AgentD/COMPUTRON-3000/(list of files, drawings)

Other design files:
himem.pcb
main.pcb
power.pcb
romprog/romprog.pcb
uart.pcb
