AgentD/COMPUTRON-3000/(commit log)

2012-10-09 Added footprint and values to power supply
    Also removed unused I/O and address bus and added status LED and changed
    bridge to discrete diodes
    [power.sch]
2012-10-09 Added title blocks
    [cpu.sch, memory.sch, power.sch, rom_cartridge.sch]
2012-10-11 Replaced 74 573 with 574
    - Should work as well, as the data is already on the bus when the CPU
    issues an IORQ/MREQ and RD/WR strobe
    - I have a lot of those
    [cpu.sch, memory.sch]
2012-10-13 Added custom 40 pin DIN 41612 connector symbol
    [cpu.sch, memory.sch, power.sch]
2012-11-13 Turned individual boards into single main board + some overhauls
    - power supply, CPU, address decoder, memory and interrupt decoder
    on single board
    - very simple DIN41617 plain I/O bus
    - more soffisticated address decoder with shared RAM and 1kB boot
    ROM instead of shared ROM
    - no more DMA
    [cpu.sch, main.sch, memory.sch, power.sch, rom_cartridge.sch]
2012-11-17 ERMAHGERD ERSERMBLER!
    Finally sat down to write that pice of cruft. A simple stub of a
    retargetable assembler with label handling and what not.
    Currently has an Intel 8080 backend.
    I need some sleep now...
2012-11-17 Added defines to assembler and fixed syntax of the [ORG] directive
2013-01-19 Some cleaning in the assembler code
    - Made as many helper functions as possible into gerneric
    - Symbols are linked lists
    - Removed binaries
2013-01-27 Finally an update after a long break
    - Removed gschem schematics and symbols
    - Added original design documents
    - Added PCB layouts
    - Updated README
    [cpu.pcb, main.sch, mem.pcb]
2013-02-04 Moved several connections from the top to the bottom side
    [cpu.pcb]
2013-02-04 Moved power source of the bus and to seperate connectors
    [cpu.pcb, mem.pcb]
2013-02-05 Adjusted sizes of the the memory and cpu pcb to 100mm Height (Eurocard)
    [cpu.pcb, mem.pcb]
2013-02-05 Minor simplifications in the memory board pcb
    [mem.pcb]
2013-02-10 Added decoupling caps and ROM compatibillity to memory board
    - Simplified top layer connections
    - Added decoupling capacitors
    - Connected unused ROM address lines to VCC
    -> Simplified layout
    -> Compatibillity for a wide range of both EEPROMs and EPROMs
    [mem.pcb]
2013-02-10 Connected CPU clock with backplane bus
    [cpu.pcb, mem.pcb]
2013-02-10 Added script to generate gerber files
2013-02-17 Removed unsolderable connections
    The righthand rows of a 41612 connector >CANNOT< be soldered
    on the top layer when the holes don't connect the top with
    the bottom.
    Result is a little mess on the top layer of the memory board
    [cpu.pcb, mem.pcb]
2013-02-17 Revamped label handling code in assembler
    - Defines are resolved in place (not post processed)
    - Valid names for labels are only continuous strings of alpha
    numeric characters
    - Removed twos complement label type, only required if defines
    are post processed
2013-02-17 Added .blk & .loc directives to assembler and renamed DB directive
    - .blk inserts a block of fill bytes in the assembler output
    - .loc inserts moves the assembler ouput location to a given address,
    i.e. it inserts fill bytes so the next code is at the given location
    - renamed DB to .db to match other directive names
2013-02-17 Cleaned assembler immediate value handling
    - Generic function for getting a numeric value checks for
    define
    - Less code in immediate value embedding functions
2013-02-17 Added z80 support to assembler (needs cleaning & probably bug fixes)
2013-02-19 Assembler: Minor bug fixes in z80 code, minor cleanups & extensions
    - Added Makefile
    - Fixed symbol name comparison
    - Symbol lookup is done during assembly and not as a post process
    - Assembler understands $xx hex numbers and '#' commentaries
    - Minor cleanups
2013-02-19 Assembler: Bug fixes and .exp directive added
    - Symbol handling code had problems with '_' in names
    - Symbol flags were overlapping
    - Added .exp directive to mark a symbol as exported
2013-02-19 Assembler: Added resolved label list & further bug fixes
2013-02-19 Major code cleanup in assembler
2013-02-19 Specified object file format and made assembler generate object files
2013-02-20 Moved assembler, linker etc. to its own project
2013-02-26 Updated emulator to current hardware state
2013-03-11 Adjusted PCBs to manufacturer wishes
    - Only 0.8 mm drill holes
    - Metric output for gerber files
    [cpu.pcb, mem.pcb]
2013-03-29 Added LED blinking prototype test software and fixed README
2013-07-20 Moved test source files to root directory and removed emulator
    Also added UART test source
2013-07-20 Added uart board source and description
    [uart.pcb]
2013-07-20 Updated README file and gerber file generator
2013-07-20 Added memory extension board draft
    [himem.pcb]
2013-07-20 Updated power on reset circuit on cpu board
    [cpu.pcb]
2013-07-20 Removed unused/unusable BUSRQ/BUSACK lines from cpu board
    [cpu.pcb]
2013-07-21 Updated CPU description/schematics and shrinked the board size
    [cpu.pcb]
2013-07-21 Shrinked base memory board
    [mem.pcb]
2013-08-25 Upgraded RS232 plug pinout
    When wiring up the actualy prototype, it was discovered, that the
    pinout did not match the one in the PCB file
    [uart.pcb]
2013-09-27 Simplified and shrinked CPU/MEM boards
    [cpu.pcb, mem.pcb]
2015-02-09 Shrinked UART board
    [uart.pcb]
2015-02-09 Add IDE pcb
    [ide.pcb]
2015-02-09 Remov old files of V1
    [cpu.pcb, himem.pcb, ide.pcb, mem.pcb, uart.pcb]
2015-02-09 Add main board and memory extension board
    [himem.pcb, main.pcb]
2015-02-09 Remove gerber file generator script
2015-02-12 Add screwholes to mount himem board onto main board
    [himem.pcb, main.pcb]
2015-02-15 Add UARD board
    [uart.pcb]
2015-02-15 Add power supply and reset circuit board
    [power.pcb]
2015-02-21 Replaced individual resistors with resistor array
    [power.pcb]
2015-02-21 Add ROM programmer files
    [romprog.pcb]
